jamwu/CC1101_lowpower_net/README.md

# CC1101_lowpower_net
STM8+CC1101
# 2018.05.05
## V1.2
### 1.低功耗终端载波防碰撞与WOR相结合。
### 2.WOR设置为休眠周期300ms，唤醒窗口585us。
### 3.WOR唤醒窗口接受方式为检测同步字与前导码。大大提升接收成功率。
### 4.采用网关一直重复发，直到收到终端ACK停止发送的机制。
### 5.配合ACK，优化之前设计的协议，减少帧长，缩短发送时间。
# 2018.05.06
## V1.3
### 1.由于程序逻辑与机制越来越复杂，针对STM8找到了一个适用的轻量级RTOS:Atomthreads。
### 2.成功将Atomthreads移植到网关模块。
### 3.基于RTOS优化底层框架，将uart、timer、超时机制、RF驱动等程序线程化。
将各中断服务程序适配到RTOS。
高优先级任务采用sem机制阻塞，等待触发，特别涉及到GPIO、UART、Timer中断部分。<br>
uart串口在任务上实现透传功能，串口数据采用消息队列机制。<br>
# 2018.05.07
## V1.4
### 1.由于STM8L101只有8KbFlash,1KbRAM,程序在写到第5个任务线程时，编译代码空间溢出,是RAM不够用了。<br>
故放弃使用RTOS:atomthreads,继续使用RTOS前的裸机代码，并完善底层。<br>

# 2018.05.08
## V1.5
### 1.实现网关与网关之间的简单的通信流程机制。
网关与网关之间发送数据，接收到ACK后结束。<br>
具有载波防碰撞机制，ACK超时机制。<br>
### 2.优化无线收发数据缓冲区的结构体组织。
修复一个小BUG：收发缓冲区误配置为同一个存储区，导致接收数据后，部分帧头数据被发送的ACK覆盖掉，最后获得的接收的数据不正确。<br>

# 2018.05.09
## V1.6
### 1.重新设计载波防碰撞机制
载波防碰撞：在发送无线数据前，先对信道进行监听，若信号强度超过设定的RSSI阈值，则说明有信号，<br>
则暂不发送，待延时一段时间，再发送无线数据。<br>
载波防碰撞实现有三种机制：CS、CCA、直接RSSI比较。<br>
##### 载波监听 (CS):CC1101内部载波监听机制，可用于空闲信道评估。<br>
CS可由状态寄存器读取到，有两种触发方式：<br>
1.当 RSSI 大于可编程绝对阈值时 CS 有效，而 RSSI 小于该可编程绝对阈值（有滞后）时则 CS 无效。<br>
2.在 RSSI 采样值从一个到下一个采样值过程中 RSSI 增加可编程 dB 数时置位 CS；<br>
在 RSSI 降低至相同的 dB 数时则取消 CS。该设置不依赖于绝对信号电平，因此，在具有时变噪声底限的环境中对检测信号十分有用。<br>
##### 空闲信道评估 (CCA)：CC1101内部空闲信道评估机制。<br>
空闲信道评估(CCA)用于表明当前信道是空闲还是忙碌。<br>
CC1100E 处于 RX 状态下，当发出 STX 或 SFSTXON 指令选通脉冲时，只有满足空闲信道要求的情况下才会进入 TX 或 FSTXON 状态。<br>
否则，芯片就会保持 RX 状态不变。如果随后信道可用，那么在通过 SPI 发送一条新的指令选通脉冲以前该无线电设备都不会<br>
进入 TX 或 FSTXON 状态。这种特性被称为“TX-if-CCA”。<br>
##### 直接RSSI比较<br>
自定义一个RSSI阈值，在发送无线数据时，在设置到发送模式之前，先设置为接收模式，然后读取RSSI值，<br>
将RSSI与自定义的RSSI值相比，若实测RSSI值大于设定阈值，则暂不发送，待延时一段时间，再发送无线数据。<br>
##### 在以上三种方式中，在之前的网关设备上全部成功实现。而后采用了CCA方案。<br>
CCA方案在实现ACK的网关上可用，因为网关不考虑功耗，大部分时间都处于接受状态。<br>
在具有WOR的低功耗终端上出现问题，网关突发数据时，先从休眠状态切换为空闲状态，然后设置为接收状态，此时RSSI读取正常，<br>
信道无载波，RSSI值约为-87dBm,小于设定的CS阈值-60dBm,但此时CC1101内部CCA信号指示信道不空闲，导致无论如何，<br>
终端都认为信道忙，不发送无线数据。<br>
故弃用CCA方案，选择直接RSSI比较方案。直接RSSI方案成功实现网关、终端的防碰撞机制。<br>
在网关上，切换到接受状态后可无需延时直接读取RSSI，提升载波防碰撞响应速度。<br>
在终端上，由于需要一个稳定建立时间，切换到接收状态后要1ms的延时，才能读到正确的RSSI的值。<br>
载波防碰撞的超时时间设置为1s，短时延为10ms，即：<br>
在发送无线数据时，若信道忙，则延时10ms，再发送，以此循环，若1s内发送仍不成功，则超时，放弃发送。<br>
### 2.设计网关与终端通信机制<br>

|数据流程| | |
|---|---|---|
|网关|1.-->数据*|终端
|网关|2.<--ACK|终端
| | |
|网关|1.<--数据|终端
|网关|2.-->ACK*|终端
|网关|3.<--ACK|终端

说明：<br>
1.箭头方向表示发送数据方向。<br>
2.\*表示持续发送，直到接收到ACK为止。<br>
3.通信流程到网关收到ACK结束。<br>
4.持续发送的超时时间设置为2S。<br>
5.等待ACK超时时间为2S。<br>
网关向终端发送无线数据时，采用的机制是循环发送，直到接收到终端返回的ACK停止。<br>
循环发送的超时时间设置为2s,短延时为50ms，即：<br>
在网关向终端发送无线数据时，循环发送。一次发送完毕后，设置为接收模式，延时50ms，等待终端返回的ACK信号。<br>
若接收到ACK信号，则结束发送，若循环发送2s内没接收到ACK，则超时，放弃发送。<br>
终端为低功耗模式，使用WOR。WOR配置为EVENT0周期时间为300ms，在此周期中RX Time为584us,即终端每300ms唤醒一次，<br>
接收窗口期只有584us。测试时发现，由于窗口期太窄，发送无线数据的时间很难刚好对上窗口期，导致网关持续发送几乎到4、5秒，<br>
终端才收到一次数据。<br>
故修改设置，缩短唤醒周期时间为100ms，接收窗口期设置为1.58ms。修改了此设置后，实测网关持续发送2s时，终端总能稳定收到2次数据。<br>
### 3.实现了上述网关与终端的应答机制<br>

# 2018.05.10
## V1.7
### 1.更新无线组网与通信协议。<br>
将功能字与类型分拆开来，以解决：<br>
1.区分返回不同类型的ACK的问题。<br>
2.区分广播群发后的返回ACK地址问题。<br>
3优化通信结构。<br>
无线协议帧头<br>

****

|0|1|2|3|4|5…|
|---|---|---|---|---|---
|起始|本机地址|目标地址|功能字|类型|数据
|EB|local addr|target addr|01获取网关地址|01ACK|	 
| | | |02获取终端地址|02CMD|	 
| | | |03终端申请地址| | 
| | | |04返回申请地址| | 
| | | |05数据透传| | 

****

### 2.设计终端和网关的地址相关协议。<br>

|地址|类型|标记
|---|---|---|
|0x00 | 广播 |  TYPE_BROADCAST 
|0x01 ~ 0x0A | 网关地址 |  TYPE_GATEWAY  
|0x0B ~ 0xFE | 终端地址 |  TYPE_TERMINAL 

所有网关初始地址为0x01,网关自分配地址。<br>
所有终端初始地址为0x0B，终端需向网关申请地址。<br>
共255个地址。<br>
组网结构为星型结构，每个网关可支持244个终端地址，一个区域内最多10个网关。<br>
网关间可通信。<br>
终端之间不可通信。<br>
建立两个地址池：<br>
INT8U Device_addrpool[255]={0};//地址分配池<br>
INT8U Device_aliveadd[255]={0};//设备在线池<br>
其中地址分配池用于标记已分配的地址，<br>
为1则地址已占用，0则未占用。<br>
设备在线池用于标记在线的网关和终端设备。<br>
当接收到无线数据时，提取到帧中的发送端的地址后对地址进行标记，<br>
在地址分配池中，该地址对应的数置1，表示地址已占用，置1后不再清零。<br>
在设备在线池中，该地址对应的数++，最多加到3。<br>
当发送无线数据时，若发送成功，返回的ACK也对其地址进行了上述标记。<br>
若发送失败，则设备在线池中，该地址对应的数--，最低为0，则数值>0表示设备在线，数值为0表示设备不在线。<br>
### 3.设计地址分配程序<br>
#### 1.网关自分配地址流程：<br>
上电初始化时，先读取EEPROM里存的RF配置标记位，<br>
若为0则表示该设备未经初始化，需要进行RF网络初始化，<br>
若为1则表示该设备已初始化过，从EEPROM里读取配置数据，如本机地址等。<br>
网关RF网络初始化：<br>
1.广播发送寻找网关指令。<br>
2.等待2s,在这2秒中，若有其他网关收到该指令，则会返回ACK。<br>
3.利用返回的ACK对地址池进行标记。<br>
4.从前往后在地址分配池里从0X01 ~ 0X0A遍历，若有地址对应的值为0，说明未被占用，<br>
则跳出遍历，将该地址设置为本网关的地址，并对该地址进行标记。<br>
#### 2.设计终端选择最优网关流程<br>
利用设备在线池里的数据，在0x00~0x0A范围内，从前往后找最大值（最大为3），<br>
选择最大值为3是考虑到，若网关突然掉线，则只要最多3次连接失败就标记网关不在线，并切换网关。<br>
若一直加到255，则反应时间太慢，需要发送很多次，值才能递减到0。<br>
用返回的最大的值对应的地址设置为网关地址。<br>
这样，选择网关是依据最多次成功连接来的，而且支持动态选择网关。<br>
若返回为0，则说明设备在线池里没有可用网关，则终端广播发送寻找网关指令。<br>
### 4.修复读写EEPROM的BUG。<br>
STM8的FLASH与EEPROM共用8KB空间，EEPROM为2KB，之前从起始位置读取，发现已经覆盖程序区了，<br>
导致各种难以找原因的运行错误。现在优化为从空间最末位置开始，倒序往前读写EEPROM，程序运行恢复正常。<br>
### 5.完成寻找网关、网关初始化时自分配地址功能。<br>
测试环境：3个网关，两个初始化过的网关，地址为0x01与0x02，一个未初始化过的网关，初始地址为0x01。<br>
1.只运行0x01网关，网关初始化后地址自配置为0x02<br>
2.只运行0x02网关，网关初始化后地址自配置为0x01<br>
3.运行0x01和0x02网关，网关初始化后地址自配置为0x03<br>

# 2018.05.11
### 1.将网关修改与增加的部分功能代码适配到终端的代码中。
### 2.终端的工程增加寻找网关并选择最优网关的功能，机制有待测试。
### 3.设计网关的串口通信、终端的串口通信机制。
网关串口协议<br>

|0|1...
|---|---
|目标地址|数据
|target addr| |

网关串口接收到的数据要转发到终端上，故接收的数据必须要有一个确定的终端的地址来发送数据。<br>
网关在收到串口数据后，发送前需打包数据，先添加帧头，在帧头中放入本机地址、要发送的终端地址、功能字05（表示数据透传）、类型02CMD，<br>
在其后为接收到的串口数据（去除0目标地址）<br>
网关在收到无线数据时，若类型为02CMD，功能字为05（数据透传），则将除去帧头的数据发送到串口。<br>
<br>
终端串口协议<br>

|0...
|---
|数据

终端串口接收的数据无协议。<br>
终端收到串口数据后，发送前先选择最优网关，然后打包数据，添加帧头。<br>
终端在收到无线数据时，若类型为02CMD，功能字为05（数据透传），则将除去帧头的数据发送到串口。<br>
### 4.写了测试RSSI数据.xlsx文件，在/DOC中。
内容为几张配置表：<br>
1.与确定RSSI阈值有关的三张表typical RSSI value(dBm)、target value、absolute RSSI threshold。<br>
2.CS threshold 的RSSI阈值确定的公式。<br>
the RSSI value at CS threshold = typical RSSI value + (target value - 33) + (0 + absolute RSSI threshold)<br>
3.CS threshold 的RSSI阈值配置的示例与实际配置。<br>
4.将RSSI的寄存器值转换为实际值的表Typical RSSI_offset Values与过程。<br>
5.根据实际配置参数选择的RSSI_offset Value。<br>
6.根据实际配置参数在实际环境下测得的不同距离的RSSI寄存器值和实际RSSI值。表：Test RSSI value<br>
说明：RF实际配置参数记录在/DOC/配置参数.xlsx文件中。<br>
### 5.to do list:
1.测试终端寻找网关机制。<br>
2.测试终端选择最优网关机制。<br>
3.测试终端向网关申请地址机制。<br>
4.测试终端、网关的串口透传机制。<br>

# 2018.05.15
## V1.8
### 1.将网关与终端程序合并为一个工程，在程序中用设备类型来做区分。
通过上电时按功能键的时间来选择设备是终端还是网关。<br>
若上电时不按按键，则默认设备为终端。<br>
若上电时按按键时间超过3s，则设置设备为网关。<br>
若上电时按按按键时间大于1s，小于3s,则RESET设备。<br>

### 2.测试终端寻找网关机制遇到的问题：
1.发送完寻找网关指令后，网关切换到接收模式，等待2s来接收其他终端发送的地址应答。<br>
而对于终端来说，发送完寻找网关指令后，终端进入休眠模式。必须要切换到接收模式来接收地址应答。<br>
2.终端从休眠切换到接收模式，需要先进入空闲模式，进入空闲模式后，延时一段时间待CC1101运行稳定后再切换到接收模式。<br>
3.由于终端从休眠到接收要一点时间，而原本网关在收到寻找网关指令后会立即返回地址应答，这会导致终端错过地址应答。<br>
设置终端从休眠到接收稳定延时时间为1ms，设置网关在收到寻找网关指令后延时2ms返回地址应答。<br>

### 3.合为一个工程后，继续对网关自分配地址功能进行测试，遇到问题：
场景：设置3个网关，烧入一样的程序。<br>
网关1上电，初始化时寻找网关，由于没有网关，自分配地址为0x01(默认网关地址)。<br>
随后网关2上电，初始化时寻找网关，收到网关1的地址应答，自分配地址为0x02。<br>
接着网关3上电，初始化时寻找网关，遇到问题：<br>
1.网关3发送寻找网关指令，网关2收到后发送了地址应答，由于地址应答是广播，网关1收到了网关2的地址应答，<br>
然后前一条寻找网关的指令被覆盖，网关1不再发送地址应答到网关3，网关3配置地址为0x01(默认网关地址)。（先后顺序随机）<br>
2.网关3发送寻找网关指令，网关1和2都收到了，并都发送了地址应答。网关3只收到其中1个地址应答，从而地址分配错误。<br>
3.先前网关发送ACK的机制是一直发送，直到收到ACK为止。网关3发送寻找网关指令，网关2收到并发送地址应答，由于网关3未返回应答，<br>
网关2一直发送地址应答，网关1则不停的收到网关2的地址应答，直到网关2接收应答超时。为此将网关的地址应答从应答中分离开来，<br>
去除一直发直到接收到ACK的机制，直保留载波防碰撞机制。<br>

### 4.后续思路：
1.根据各设备间的通信特性重新优化组网协议。<br>
2.打算取消掉网关的地址分配机制，所有网关用同一个地址。<br>
3.网关间定时发送心跳包，同步终端地址池。<br>
4.终端可以往任意一个网关发送数据、申请地址。<br>
# 2018.05.16
## V1.9
通信机制特性总结：<br>
1.设备可以广播，但是不能群收（群发时只收一个）。<br>
2.终端由于周期性休眠，发送数据到终端必须持续发送，否则终端可能会收不到。<br>
3.终端收到数据后必须给一个应答来结束持续发送。<br>
### 1.根据通信机制特性优化网络组网机制与协议：
无线协议V1.3<br>
无线协议帧头<br>

|0|1|2|3|4|5…|
|---|---|---|---|---|---
|起始|本机地址|目标地址|功能字|类型|数据
|EB|local addr(终端地址)——>|0x01(网关地址)|01数据透传|01ACK|	 
| |0x01(网关地址)|target addr|02终端申请地址|02CMD|	 
| | | |03网关间同步地址池| | 

1.所有网关统一地址为0x01。<br>
2.终端未初始化地址为0x02,可用地址为0x03~0xFE，共251个地址。<br>
若终端读取配置，发现本机地址为0x02，则向网关发送申请地址指令。<br>
3.整个网络中，终端地址唯一，即网关间定时同步地址池。<br>
暂定网关间每500ms进行同步地址池，同步地址池不需要接收应答。<br>
4.终端间不可通信，终端发送地址只有0x01。<br>
（如有需求，后期可做网关转发功能）<br>
5.删除分配网关地址功能。<br>
6.删除寻找网关、寻找终端指令与功能。<br>
### 2.删除初始化标记。
若本设备为终端，则只有终端的地址需要初始化，RESET操作只要将终端地址设置为未初始化地址即可。<br>
若本设备为网关，RESET操作清除保存在EEPROM中的地址池数据。<br>
且初始化只在上电后执行，运行过程中不会执行初始化。<br>
初始化后的数据掉电也保存。<br>
每次上电，终端检测本机地址是否为未初始化地址，若是，才进行初始化操作。<br>
每次上电，网关先读取存在EEPROM中的地址池数据。<br>
### 3.不支持删除地址操作，地址池里的地址一旦标记不会删除，除非所有网关都进行初始化。
### 4.地址池的地址采用位存储，255个字节使用32个字节（一个字节8位）。
节省EEPROM存储空间，减短地址同步的帧长,长度：5字节帧头 + 32字节地址池数据。
### 5.若收到地址同步后，比对发现有新增设备时，将更新的内容保存到EEPROM,否则不保存。
### 6.修复一些细节性小BUG。
# 2018.05.17
## V2.0
### 1.由于一些初始化逻辑问题，加上初始化标记位。
### 2.增加EEPROM连续读写多字节函数。
封装好地址池更新、读取到EEPROM函数。
### 3.优化地址在线池与地址在线标记功能。
地址池各网关间同步，地址在线池不同步。
### 4.flash空间不足
8KB flash 地址范围为0x8000 —— 0x9FFF,<br>
其中0x8000 —— 0x807F 为interrupt vectors<br>
0x8080 —— 0x9FFF 为flash program memory including Data EEPROM.<br>
DEBUG查看memory发现代码空间已占用到0x9fef,剩余的空间只有16byte。<br>
对于终端设备，需要4字节<br>

|名称|大小|说明
|---|---|---|
|RF_INIT_FLAG           |1byte      |RF初始化标记  
|RF_Local_DeviceType    |1byte      |RF本地设备类型
|Local_ADDR             |1byte      |RF本机地址
|Target_ADDR            |1byte      |RF目标地址

对于网关设备，需要36字节，空间不足。<br>

|名称|大小|说明
|---|---|---|
|RF_INIT_FLAG           |1byte      |RF初始化标记  
|RF_Local_DeviceType    |1byte      |RF本地设备类型
|Local_ADDR             |1byte      |RF本机地址
|Target_ADDR            |1byte      |RF目标地址
|Addpool                |32byte     |RF终端地址池

优化程序:<br>
1.删除没有用到的库文件，没有效果（编译器已经做了优化）。<br>
2.调整编译器优化设置：<br>
Optimizations:<br>
level ——>High(size)<br>
Enable transformations:<br>
Common subexpression elimination<br>
Loop unrolling<br>
Function inlining<br>
Code motion<br>
Type-based alias analysis<br>
Cross call<br>
3.精简了部分代码结构，能合在一起写就合在一起写。<br>
4.尽可能能用局部变量代替全局变量。<br>
空间仍不足。<br>

# 2018.05.29
## V2.1
### 1.重启低功耗网关项目，移除自组网的框架与功能，不再使用自组网机制。
#### ——1.缩减代码
针对芯片flash空间不够的问题，缩减代码：<br>
删除地址池、地址自动分配、管理、在线设备标记、地址EEPROM存储等功能。<br>
根据删除的程序、功能与变量进一步优化代码，保持紧凑性。<br>
#### ——2.修改无线通讯与组网协议
V1.4<br>
无线协议帧头：

|0|1|2|3|4|5...| 
|---|---|---|---|---|---|
|起始|本机地址|目标地址|功能字|类型|数据|
|EB|终端地址0X02-0XFE|网关地址0X01|01数据透传|01ACK|
||网关地址0X01|target addr|02配置目标地址|02CMD|

V1.3<br>
串口发送协议：

|0|1|2|3|4...|
|---|---|---|---|---|
|起始|目标设备|目标地址|功能字|数据|
|EB|9C本机|0表示本地|01数据透传|
||91无线收发方|无线地址0X01-0XFE|02配置目标地址|

#### ——3.调整部分函数结构与名称
#### ——4.优化RESET机制
只保留本机地址的EEPROM存取的数据与功能，其他数据如本机类型等全都删除。<br>
优化的RESET机制：<br>
模块上电时，或复位时按住功能按键，指示灯亮，长按3秒以上，模块初始化为网关，<br>
配置网关实质是将本机地址配置为0X01，即网关地址，后续逻辑、与功能自动根据地址进行不同操作。<br>
按下按键时间小于1s，模块初始化为终端，配置本机地址为0x02，0X02为初始化终端地址。<br>
对于地址为0X02的终端设备，后续要支持网关或串口发送配置地址指令进行地址配置。<br>

# 2018.05.30
## V2.2
### 1.指导学弟的毕设，解答低功耗问题。
重点解答了WOR模式中EVENT0和EVENT1的内容：<br>
EVENT0是从上一次唤醒到下一次唤醒的整个周期，EVENT0包含EVENT1,EVENT0事件触发时<br>
无线芯片从休眠开始唤醒。<br>
唤醒后，芯片有一个时钟恢复时期，此时从休眠状态转换为空闲状态，这个恢复时期需要<br>
一定的时间，然后芯片要切换到接收模式。从开始唤醒到芯片自己发出切换到接收状态指令这<br>
段时间为EVENT1的时间，EVENT1事件触发时，无线芯片自己发出切换到接收状态的指令。<br>
故EVENT1有一个最短时间限制，根据手册，一般较短的EVENT1时间可设置为346us。<br>
无线芯片自己发出切换到接收状态指令后，芯片从空闲到接收状态有一个建立时间T(IDLE to RX)<br>
T(IDLE to RX)一般为798.8us。到接收状态后，有一个RX timeout，即在芯片没有接收到<br>
无线数据时，RX状态的最大接收时间。RX timeout是要自己配置的，配置是按照EVENT0的<br>
占空比来设置。若EVENT0为300ms，占空比设置为12.5%，则RX timeout为37.5ms。<br>
没有接收到无线数据，且RX接收时间达到timeout时，芯片会从RX切换到空闲状态，<br>
T(IDLE)一般为150us。T(IDLE)时间后，芯片进入休眠状态，等待下一次的唤醒。<br>
T(SLEEP)有一个最短时间限制，为11.08ms。<br>
故整体来看：<br>
T(EVENT0)=T(EVENT1)+T(IDLE to RX)+T(RX timeout)+T(IDLE)+T(SLEEP)<br>
其中需要自己配置的有三个参数T(EVENT0)、T(EVENT1)、T(RX timeout)的占空比。<br>
### 2.丰富和细化无线模块的串口协议，以进一步完善功能。
#### ——1.优化协议如下：
V1.4<br>
串口发送协议：

|0|1|2|3|4...|
|---|---|---|---|---|
|起始|目标地址|功能字|类型与状态|数据|
|EB|0表示本地|01数据透传——>|数据长度|...|
||无线地址0X01-0XFE|02配置目标地址——>|地址(1byte)|None|
|||03获取本机地址——>|None|None|

串口接收协议：

|0|1|2|3|4...|
|---|---|---|---|---|
|起始|地址来源|功能字|类型与状态|数据|
|EB|0表示本地|01数据透传——>|数据长度|...|
||无线地址0X01-0XFE|02返回指令执行结果——>|状态码|None|
|||03返回本机地址——>|本机地址|None|

状态码主要用于DEBUG调试用，使用宏定义RF_PROTOCOL_DEBUG来确认程序<br>
是否加入DEBUG功能，默认不加入。<br>
状态码定义如下：<br>
V1.0<br>

|状态码|值|含义|
|---|---|---|
|UART_STATUS_OK|0X00|状态正常|
|UART_ACK_SEND_TO_GATEWAY_OK|0X01|成功向网关发送ACK|
|UART_ACK_SEND_TO_TERMINAL_OK|0X02|成功向终端发送ACK|
|UART_ACK_GET_FROM_GATEWAY_OK|0X03|收到来自网关的ACK|
|UART_ACK_GET_FROM_TERMINAL_OK|0X04|收到来自终端的ACK|
|UART_RF_SEND_TERMINAL_ADDR_OK|0X05|无线成功发送配置终端地址|
|UART_RF_SET_TERMINAL_ADDR_OK|0X06|无线成功设置终端地址|
|UART_SET_LOCAL_ADDR_OK|0X07|成功设置本地地址|
|UART_RF_DATA_SEND_OK|0X08|成功发送数据|
|UART_RF_SEND_CCA_BUSY|0X09|发送时，无线信道忙|
|UART_ACK_SEND_TO_GATEWAY_FAIL|0X0A|向网关发送ACK失败|
|UART_ACK_SEND_TO_TERMINAL_FAIL|0X0B|向终端发送ACK失败|
|UART_RF_SEND_TERMINAL_ADDR_FAIL|0X0C|无线发送配置终端地址失败|
|UART_RF_DATA_SEND_FAIL|0X0D|无线发送数据失败|

#### ——2.设定一些限制：
1.串口发送数据时，除却帧头，最大数据长度为55字节。<br>
2.网关不可以给自己配置地址，无论指令是来自串口还是无线。<br>
3.只有网关才有权无线配置终端地址。<br>
4.终端配置地址的指令可以来自于串口或无线，但地址不可以配置成<br>
广播、网关和终端默认地址。<br>
5.终端之间不可以进行通信，网关之间不可以通信，只有终端和网关间可通信。<br>
6.ACK应答只可以在无线和终端之间发生。<br>

## 2018.05.31
### 1.进行网关模块功能测试，主要测试通信过程是否正常，以及协议功能是否正常<br>
#### ——1.测试网关、终端间互发数据，修复发送内容为55字节时，实际发送为0的BUG。<br>
本机为网关，测试数据如下：<br>
##### 网关向终端发送数据（hex）：
EB 02 01 37 00 01 02 03 04 05 06 07 08 09 10 11 12 13 14 15 16 17 18 19 20 21 22 23 24 25 26 27 28 29 30 31 32 33 34 35 36 37 38 39 40 41 42 43 44 45 46 47 48 49 50 51 52 53 54 <br>
帧头：<br>
EB 02 01 37：起始+无线地址+功能字（01数据透传）+数据长度（0x37,55个字节）<br>
数据：<br>
00 01 02 03 04 05 06 07 08 09 10 11 12 13 14 15 16 17 18 19 20 21 22 23 24 25 26 27 28 29 30 31 32 33 34 35 36 37 38 39 40 41 42 43 44 45 46 47 48 49 50 51 52 53 54<br>
##### 返回：<br>
EB 02 01 37 00 01 02 03 04 05 06 07 08 09 10 11 12 13 14 15 16 17 18 19 20 21 22 23 24 25 26 27 28 29 30 31 32 33 34 35 36 37 38 39 40 41 42 43 44 45 46 47 48 49 50 51 52 53 54 EB 00 02 08 EB 02 02 04 <br>
数据回传：<br>
EB 02 01 37 00 01 02 03 04 05 06 07 08 09 10 11 12 13 14 15 16 17 18 19 20 21 22 23 24 25 26 27 28 29 30 31 32 33 34 35 36 37 38 39 40 41 42 43 44 45 46 47 48 49 50 51 52 53 54 <br>
DEBUG数据：<br>
EB 00 02 08：发送数据成功<br>
EB 02 02 04：收到终端ACK<br>
##### 终端向网关发送数据（hex）：
##### 网关接收：<br>
EB 02 01 37 01 02 03 04 05 06 07 08 09 10 11 12 13 14 15 16 17 18 19 20 21 22 23 24 25 26 27 28 29 30 31 32 33 34 35 36 37 38 39 40 41 42 43 44 45 46 47 48 49 50 51 52 53 54 55 EB 00 02 02 EB 02 02 04 <br>
帧头：<br>
EB 02 01 37：起始+无线数据发送地址+功能字（01数据透传）+数据长度（0x37.55个字节）<br>
接收数据：<br>
01 02 03 04 05 06 07 08 09 10 11 12 13 14 15 16 17 18 19 20 21 22 23 24 25 26 27 28 29 30 31 32 33 34 35 36 37 38 39 40 41 42 43 44 45 46 47 48 49 50 51 52 53 54 55<br>
DEBUG数据：<br>
EB 00 02 02：成功向终端发送ACK<br>
EB 02 02 04：收到终端ACK<br>
#### ——2.测试终端本机通过串口指令配置本机地址功能
1.修复配置好地址后没有同步到无线芯片配置地址指令的BUG。<br>
2.修复串口配置地址时，无线芯片处于休眠状态，地址没有及时更新的BUG。<br>
3.测试配置地址指令、获取本机地址指令，通过。<br>
#### ——3.测试网关通过无线配置终端地址功能
网关发送指令：<br>
EB 02 02 03：起始+目标地址+功能字（02配置目标地址）+要配置的地址（1byte）<br>
接收数据：<br>
EB 02 02 03 EB 00 02 05 EB 03 02 06 <br>
数据回传：<br>
EB 02 02 03<br>
DEBUG数据：<br>
EB 00 02 05：成功发送配置地址<br>
EB 03 02 06：无线成功设置地址<br>
### 2.配置STM8低功耗模式
1.由于无线芯片采用WOR模式，好处就是无需MCU控制芯片的休眠与唤醒，<br>
故STM8采用完全休眠（halt）模式，此模式下，系统时钟关闭，所有外设时钟也关闭，<br>
MCU的数字部分几乎不消耗电量，整个芯片大致电流0.4uA(3.3V)。<br>
2.配置方式：<br>
    -MCU上电初始化时，若本机为终端，则在让无线进入WOR后，MCU进入halt模式。<br>
    -每次处理完串口发过来的数据后，终端的MCU进入halt模式。<br>
    -每次处理完无线发过来的数据后，终端的MCU进入halt模式。<br>
3.halt唤醒方式，两处外部IO中断：<br>
    -无线芯片的GD0在接收到同步字时产生跳变沿，唤醒MCU，在接收到同步字时<br>
    不做任何其他工作，仅唤醒MCU。GD0在接收完毕也有跳变沿，从同步字到接收完毕的<br>
    时间足够MCU唤醒到正常工作状态，然后MCU接收无线数据，并处理。<br>
    -终端模块外部的IO作为触发唤醒功能，在外部设备要发送串口数据时，先向此IO发送一个<br>
    下降沿，使MCU唤醒。在此种唤醒方式下，MCU的串口会输出就绪帧。<br>
    帧如下：<br>
    EB 00 02 00:起始+本地设备标记+功能字（02返回指令执行结果）+00（设备状态正常）<br>
    收到此帧数据后,外部设备可向终端模块串口发送数据。<br>
### 3.测试终端低功耗模式下的电流消耗与通信功能
1.测试STM8处于工作状态，无线处于WOR模式时，电流消耗为3.67mA。<br>
2.测试STM8处于halt状态，无线处于WOR模式时，电流消耗为60uA。<br>
3.修复STM8没有等待串口发送数据完毕时就进入halt模式，电流消耗1.28mA的BUG。<br>
4.修复上电初始化后，终端执行了halt指令，但是STM8并没有进入halt模式的BUG。<br>
5.测试完整低功耗模式下终端与网关之间通信的功能，测试通过。<br>
