jamwu/CC1101_lowpower_net/DOC/file_struct.JPG

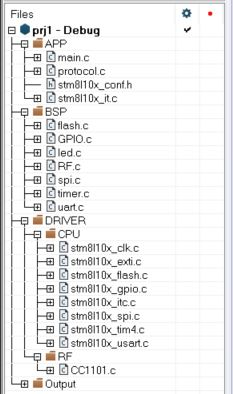
DOC/file_struct.JPG
