jamwu/CC1101_lowpower_net/DOC/mem_content.JPG

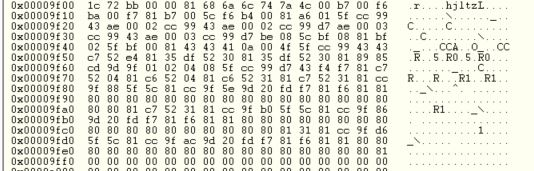
DOC/mem_content.JPG
