jamwu/CC1101_lowpower_net/DOC/mem_map.JPG

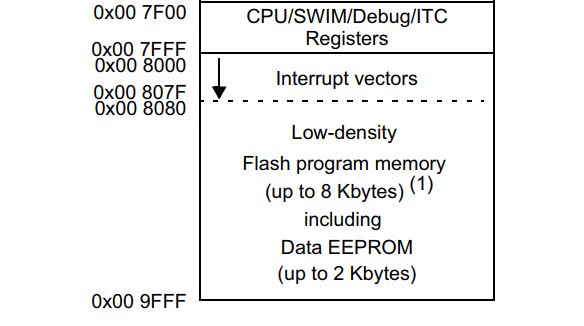
DOC/mem_map.JPG
