jamwu/CC1101_lowpower_net/DOC/optimization.JPG

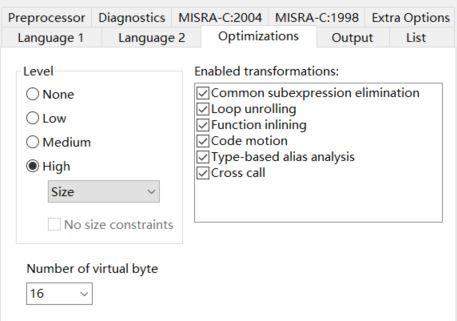
DOC/optimization.JPG
