jamwu/CC1101_lowpower_net/DOC/原理图.pdf

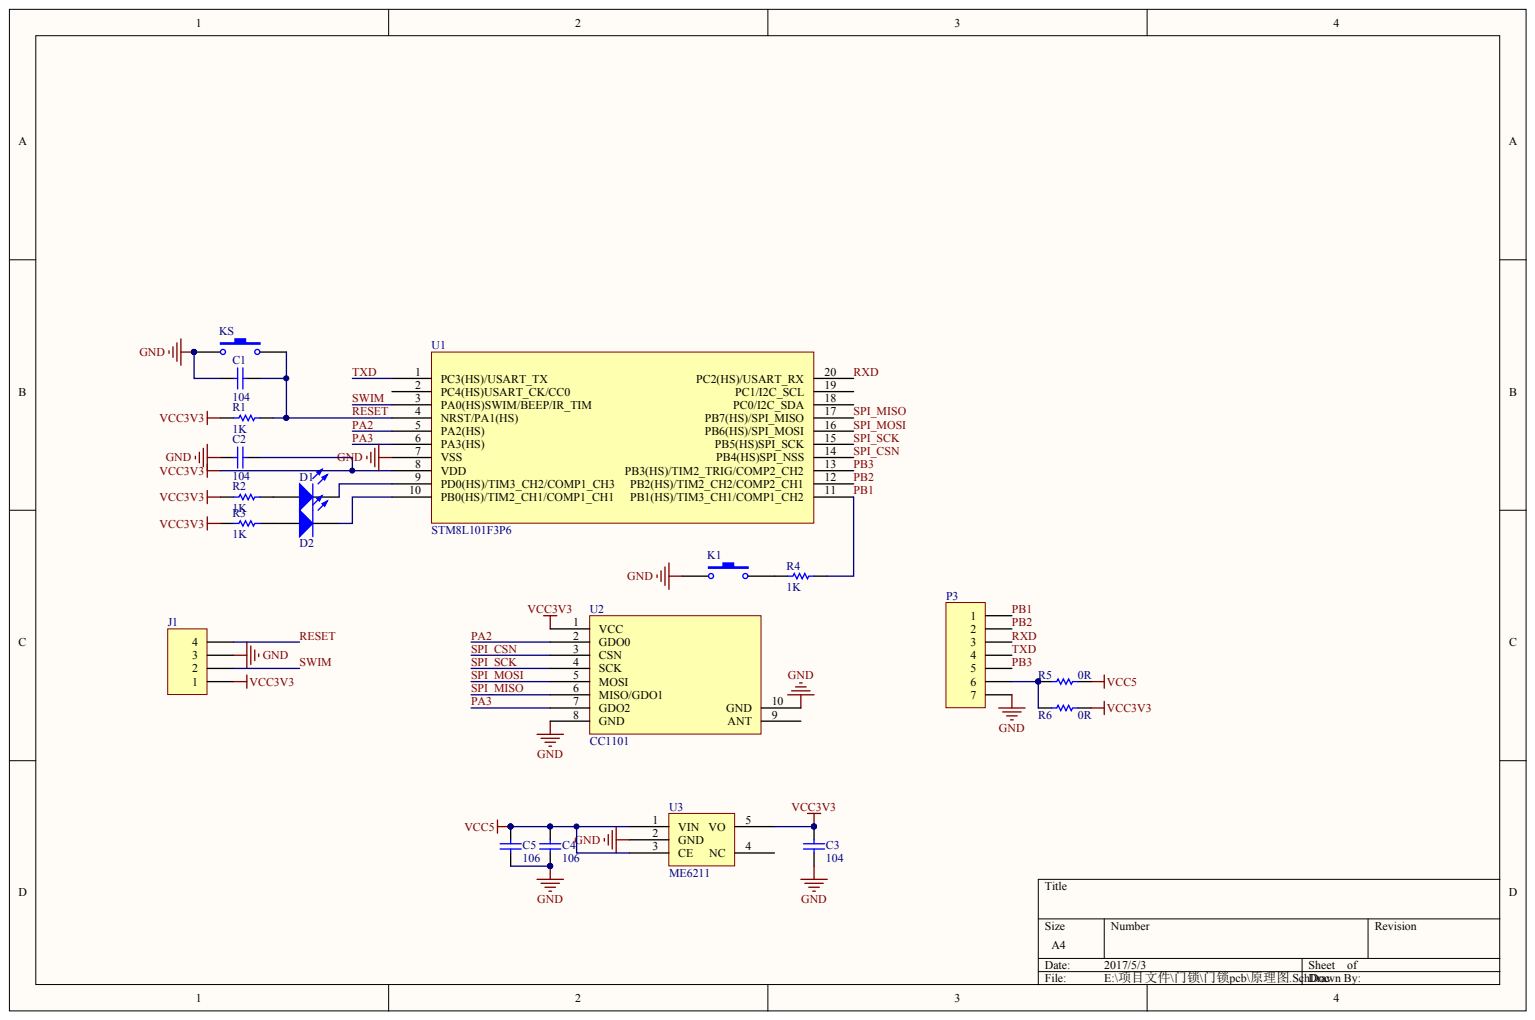
[picture p5: page 1]

Comment | Description | Designator | Footprint | LibRef | Quantity
Cap | Capacitor | C1, C2, C3, C4 | 0402 | Cap | 4
Cap | Capacitor | C5 | C0805 | Cap | 1
LED0 | Typical INFRARED GaAs LED | D1, D2 | 0603 | LED0 | 2
Header 4 | Header, 4-Pin | J1 | HDR1X4 | Header 4 | 1
SW-PB | Switch | K1, KS | 按键2 | SW-PB | 2
Header 7 | Header, 7-Pin | P3 | HDR1X7 | Header 7 | 1
Res1 | Resistor | R1, R2, R3, R4, R5, R6 | 0402 | Res1 | 6
STM8L101F3P6 | | U1 | STM8 | STM8L101F3P6 | 1
CC1101 | | U2 | CC1101 | Component_1 | 1
ME6211 | | U3 | ME6211 | ME6211 | 1
