jamwu/CC1101_lowpower_net/WOR/APP/src/stm8l10x_it.c

/**
  ******************************************************************************
  * @file stm8l10x_it.c
  * @brief This file contains all the interrupt routines.
  * @author STMicroelectronics - MCD Application Team
  * @version V1.1.0
  * @date    09/14/2009
  ******************************************************************************
  *
  * THE PRESENT FIRMWARE WHICH IS FOR GUIDANCE ONLY AIMS AT PROVIDING CUSTOMERS
  * WITH CODING INFORMATION REGARDING THEIR PRODUCTS IN ORDER FOR THEM TO SAVE
  * TIME. AS A RESULT, STMICROELECTRONICS SHALL NOT BE HELD LIABLE FOR ANY
  * DIRECT, INDIRECT OR CONSEQUENTIAL DAMAGES WITH RESPECT TO ANY CLAIMS ARISING
  * FROM THE CONTENT OF SUCH SOFTWARE AND/OR THE USE MADE BY CUSTOMERS OF THE
  * CODING INFORMATION CONTAINED HEREIN IN CONNECTION WITH THEIR PRODUCTS.
  *
  * <h2><center>&copy; COPYRIGHT 2009 STMicroelectronics</center></h2>
  * @image html logo.bmp
  ******************************************************************************
  */

/* Includes ------------------------------------------------------------------*/
#include "stm8l10x_it.h"
#include "stm8l10x_usart.h"    
#include "timer.h"
#include "uart.h"
#include "spi.h"  
#include "RF.h"
#include "GPIO.h"
#include "CC1101.h"
/* Private typedef -----------------------------------------------------------*/
/* Private define ------------------------------------------------------------*/
/* Private macro -------------------------------------------------------------*/
/* Private variables ---------------------------------------------------------*/
/* Private function prototypes -----------------------------------------------*/
/* Private functions ---------------------------------------------------------*/
/* Public functions ----------------------------------------------------------*/

#ifdef _COSMIC_
/**
  * @brief Dummy interrupt routine
  * @par Parameters:
  * None
  * @retval
  * None
*/
@far @interrupt void NonHandledInterrupt(void)
{
    /* In order to detect unexpected events during development,
       it is recommended to set a breakpoint on the following instruction.
    */
}
#endif

/**
  * @brief TRAP interrupt routine
  * @par Parameters:
  * None
  * @retval
  * None
*/
#ifdef _COSMIC_
@far @interrupt void TRAP_IRQHandler(void)
#endif

#ifdef _RAISONANCE_
void TRAP_IRQHandler(void) interrupt 0
#endif

#ifdef _IAR_SYSTEMS_
#pragma vector=1
__interrupt void TRAP_IRQHandler(void)
#endif
{
    /* In order to detect unexpected events during development,
       it is recommended to set a breakpoint on the following instruction.
    */
}

/**
  * @brief FLASH Interrupt routine.
  * @par Parameters:
  * None
  * @retval None
  * None
  */
#ifdef _COSMIC_
@far @interrupt void FLASH_IRQHandler(void)
#endif

#ifdef _RAISONANCE_
void FLASH_IRQHandler(void) interrupt 1
#endif

#ifdef _IAR_SYSTEMS_
#pragma vector=3
__interrupt void FLASH_IRQHandler(void)
#endif
{
    /* In order to detect unexpected events during development,
       it is recommended to set a breakpoint on the following instruction.
    */
}

/**
  * @brief Auto Wake Up Interrupt routine.
  * @par Parameters:
  * None
  * @retval
  * None
  */
#ifdef _COSMIC_
@far @interrupt void AWU_IRQHandler(void)
#endif

#ifdef _RAISONANCE_
void AWU_IRQHandler(void) interrupt 4
#endif

#ifdef _IAR_SYSTEMS_
#pragma vector=6
__interrupt void AWU_IRQHandler(void)
#endif
{
    /* In order to detect unexpected events during development,
       it is recommended to set a breakpoint on the following instruction.
    */
}

/**
  * @brief External IT PORTB Interrupt routine.
  * @par Parameters:
  * None
  * @retval
  * None
  */
#ifdef _COSMIC_
@far @interrupt void EXTIB_IRQHandler(void)
#endif

#ifdef _RAISONANCE_
void EXTIB_IRQHandler(void) interrupt 6
#endif

#ifdef _IAR_SYSTEMS_
#pragma vector=8
__interrupt void EXTIB_IRQHandler(void)
#endif
{
    /* In order to detect unexpected events during development,
       it is recommended to set a breakpoint on the following instruction.
    */
}

/**
  * @brief External IT PORTD Interrupt routine.
  * @par Parameters:
  * None
  * @retval
  * None
  */
#ifdef _COSMIC_
@far @interrupt void EXTID_IRQHandler(void)
#endif

#ifdef _RAISONANCE_
void EXTID_IRQHandler(void) interrupt 7
#endif

#ifdef _IAR_SYSTEMS_
#pragma vector=9
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
__interrupt void TIM4_UPD_OVF_IRQHandler(void)
#endif
{
    timer4_it_handler();
    TIM4_ClearFlag(TIM4_FLAG_Update);
}

/**
  * @brief SPI Interrupt routine.
  * @par Parameters:
  * None
  * @retval
  * None
  */
#ifdef _COSMIC_
@far @interrupt void SPI_IRQHandler(void)
#endif

#ifdef _RAISONANCE_
void SPI_IRQHandler(void) interrupt 26
#endif

#ifdef _IAR_SYSTEMS_
#pragma vector=28
__interrupt void SPI_IRQHandler(void)
#endif
{
    /* In order to detect unexpected events during development,
       it is recommended to set a breakpoint on the following instruction.
    */
}
/**
  * @brief USART TX Interrupt routine.
  * @par Parameters:
  * None
  * @retval
  * None
  */
#ifdef _COSMIC_
@far @interrupt void USART_TX_IRQHandler(void)
#endif

#ifdef _RAISONANCE_
void USART_TX_IRQHandler(void) interrupt 27
#endif

#ifdef _IAR_SYSTEMS_
#pragma vector=29
__interrupt void USART_TX_IRQHandler(void)
#endif
{
    /* In order to detect unexpected events during development,
       it is recommended to set a breakpoint on the following instruction.
    */
}

/**
  * @brief USART RX Interrupt routine.
  * @par Parameters:
  * None
  * @retval
  * None
  */
#ifdef _COSMIC_
@far @interrupt void USART_RX_IRQHandler(void)
#endif

#ifdef _RAISONANCE_
void USART_RX_IRQHandler(void) interrupt 28
#endif

#ifdef _IAR_SYSTEMS_
#pragma vector=30
__interrupt void USART_RX_IRQHandler(void)
#endif
{
    /* In order to detect unexpected events during development,
       it is recommended to set a breakpoint on the following instruction.
    */
    uart_rx_it_handler();
    USART_ClearFlag();
}


/**
  * @brief I2C Interrupt routine.
  * @par Parameters:
  * None
  * @retval
  * None
  */
#ifdef _COSMIC_
@far @interrupt void I2C_IRQHandler(void)
#endif

#ifdef _RAISONANCE_
void I2C_IRQHandler(void) interrupt 29
#endif

#ifdef _IAR_SYSTEMS_
#pragma vector=31
__interrupt void I2C_IRQHandler(void)
#endif
{
    /* In order to detect unexpected events during development,
       it is recommended to set a breakpoint on the following instruction.
    */
}

/******************* (C) COPYRIGHT 2009 STMicroelectronics *****END OF FILE****/
