jamwu/CC1101_lowpower_net/WOR/BSP/src/RF.c

/* Includes ------------------------------------------------------------------*/
#include "RF.h"
/* Private typedef -----------------------------------------------------------*/
/* Private define ------------------------------------------------------------*/

/* Private macro -------------------------------------------------------------*/
/* Private variables ---------------------------------------------------------*/
INT8S CS_Threshold = -60;//RSSI = -60dBm
INT8U Local_ADDR;

TRMODE RF_TRX_MODE=RX_MODE;

INT8U RF_RX_status[2]={0};
INT8U RF_RX_temp[64]={0};
INT8U RF_TX_temp[64]={0};

INT16U RF_timeout_count=0;  //GDIO超时计时
INT16U RF_check_timer=0;    //载波防碰撞超时计时
INT16U RF_check_ack_timer = 0;  //接收ACK超时计时

INT8U module_ready_flag = 0;

TX_Base_DATA tx_Base_DATA = {
  0,
  0,
  RF_TX_temp
};

RX_Base_DATA rx_Base_DATA = {
  0,
  0,
  RF_RX_temp,
  0,
  0,
  0  
};

INT8U RF_received_flag = 0; 
/* Private function prototypes -----------------------------------------------*/
/* Private functions ---------------------------------------------------------*/
void RF_configuration(void)
{
  CC1101Init();
  Local_ADDR = Get_Local_ADDR();
  if(Local_ADDR >= DEFAULT_TERMINAL_ADDR)//终端
  {
      CC1101WORInit();
  }
  CC1101SetAddress(Local_ADDR, BROAD_0);    //BROAD_0 
  RF_TRX_MODE=RX_MODE;
  if(Local_ADDR >= DEFAULT_TERMINAL_ADDR)//终端
  {
      CC1101SetSWOR();
      enableInterrupts();
      halt();
  }
  else
  {
      CC1101SetTRMode(RX_MODE);
      enableInterrupts();
  }
}

void RF_Reset_Check(void)
{
    INT16U key_press_count = 0;
    INT16U key_press_time = 0;
    while(READ_KEY == 0)//RESET操作
    {
        LED2_ON(); 
        key_press_count ++;
        if(key_press_count == 50000)
        {
            key_press_count = 0;
            key_press_time ++;
        }
    }
    if(key_press_time >= 36)//按下按键时间大于3s，设置为网关
    {
        Set_Local_ADDR(DEFAULT_GATEWAY_ADDR);
    }
    else if((key_press_time > 0)&&(key_press_time <= 12))//按下按键时间小于1s，设置为终端
    {
        Set_Local_ADDR(DEFAULT_TERMINAL_ADDR);
    }
    LED2_OFF(); 
}

void Set_Local_ADDR(INT8U Local_Addr)
{
    Local_ADDR = Local_Addr;
    CC1101SetAddress(Local_ADDR, BROAD_0);    //BROAD_0
    SaveE2PData(0, Local_Addr);
}

INT8U Get_Local_ADDR(void)
{
    return ReadE2PData(0);
}

//长度不能超过60字节
INT8U RF_TX_DATA(INT8U *txbuffer, INT8U size, INT8U addr)
{
    INT8S rssi=0;
    INT8U status = 1;
    CC1101ClrTXBuff();
    RF_TRX_MODE=TX_MODE;
    CC1101SetTRMode( RX_MODE );
    delay_ms(2);
    rssi=CC1101ReadStatus(CC1101_RSSI);
    rssi=CC1101_RSSI_Caculate(rssi);
    if(rssi < CS_Threshold)
    {
        CC1101SetTRMode( TX_MODE ); 
           
        CC1101WriteReg( CC1101_TXFIFO, size + 1);
        CC1101WriteReg( CC1101_TXFIFO, addr);
        CC1101WriteMultiReg( CC1101_TXFIFO, txbuffer, size);
        
        RF_timeout_count=0;
        while(CC_GDO0_READ() == 0)
        {
            if(RF_timeout_count >= 100)//20ms
            {
              status = 0;
              break;
            }     
        }
        RF_timeout_count=0;
        while(CC_GDO0_READ() != 0)
        {
            if(RF_timeout_count >= 100)//20ms
            {
              status = 0;
              break;
            }            
        }
    }
    else
    {
        status = 0;
        #ifdef RF_PROTOCOL_DEBUG
        uart_return(UART_LOCAL_DEVICE,UART_FRAME_RETURN_STATUS,UART_RF_SEND_CCA_BUSY);
        #endif
    }
    CC1101ClrTXBuff(); 
    if(Local_ADDR >= DEFAULT_TERMINAL_ADDR)
    {
        CC1101SetSWOR();
    }
    else
    {
        CC1101SetTRMode( RX_MODE );
    }
    RF_TRX_MODE = RX_MODE;
    return status;
}

void RF_GD0_it_Handler(void)
{
    INT8U rx_bytes;
    if(RF_TRX_MODE == RX_MODE)//接收模式
    {
        if(CC_GDO0_READ() == 0)
        {      
            if(CC1101ReadStatus(CC1101_MARCSTATE) != 17) //not in RXFIFO_OVERFLOW status
            {
                rx_bytes=CC1101ReadReg(CC1101_RXBYTES);
                if((rx_bytes & 0x7f) != 0)
                {
                    rx_Base_DATA.size=CC1101ReadReg(CC1101_RXFIFO);
                    if(rx_Base_DATA.size != 0)
                    {
                       rx_Base_DATA.size -= 1;
                       rx_Base_DATA.Target_addr=CC1101ReadReg(CC1101_RXFIFO);
                        CC1101ReadMultiReg(CC1101_RXFIFO, rx_Base_DATA.payload, rx_Base_DATA.size); 
                        CC1101ReadMultiReg(CC1101_RXFIFO, RF_RX_status, 2);   // Read  status bytes     
                        rx_Base_DATA.RSSI=RF_RX_status[0];
                        rx_Base_DATA.CRC=RF_RX_status[1] & CRC_OK;
                        rx_Base_DATA.LQI=RF_RX_status[1] & 0x7f;
                        if( rx_Base_DATA.CRC )
                        {
                            RF_get_ack();
                            RF_received_flag = 1;                                 
                        }
                    } 
                }
            }
            LED1_OFF();
            CC1101ClrRXBuff();
            if(Local_ADDR >= DEFAULT_TERMINAL_ADDR)
            {
                CC1101SetSWOR();
            }
            else
            {
                CC1101SetTRMode( RX_MODE );
            }
        }
        else//接收到sync  
        {     
             LED1_ON();
             STM8_SendBusyMode();
        }
    }
    else//发送模式
    {
        if(CC_GDO0_READ() == 0)
        {
            if(CC1101ReadStatus(CC1101_MARCSTATE) == 22)//TXFIFO_UNDERFLOW 
            {
                CC1101ClrTXBuff();
            }
        }
        else//已发送sync
        {
          
        }
    }
}

void RF_GD2_it_Handler(void)
{

}

void RF_Handler(void)
{
    if(RF_received_flag == 0)//没有接收完无线数据(优先处理无线数据)
    {
        if(uart_receive_timeout_flag == 1)//接收完一帧串口数据       
        {
            uart_receive_timeout_flag = 0;
            uart_protocol_handle();
            if(Local_ADDR >= DEFAULT_TERMINAL_ADDR)
            {
                /* Loop until the end of transmission */
                while (USART_GetFlagStatus(USART_FLAG_TC) == RESET);
                halt();
            }
            STM8_SendIdleMode();
        }
    }
    else  //接收完一帧无线数据
    {
        STM8_SendBusyMode();
        RF_received_flag = 0;  
        wireless_protocol_handle();           
        if(Local_ADDR >= DEFAULT_TERMINAL_ADDR)
        {
            /* Loop until the end of transmission */
            while (USART_GetFlagStatus(USART_FLAG_TC) == RESET);
            halt();
        }
        STM8_SendIdleMode();
    }
    if(Local_ADDR >= DEFAULT_TERMINAL_ADDR)
    {
        if(module_ready_flag)
        {
            module_ready_flag = 0;
            uart_return(UART_LOCAL_DEVICE,UART_FRAME_RETURN_STATUS,UART_STATUS_OK);
        }
    }
}
